labecoufsc/Power_PCB/Power PCB outline/images/diagrama-de-forças-tubo.png

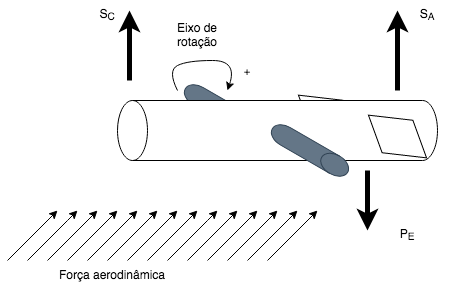
Power PCB outline/images/diagrama-de-forças-tubo.png
