labecoufsc/Power_PCB/Power PCB outline/images/diagrama-forças-final.png

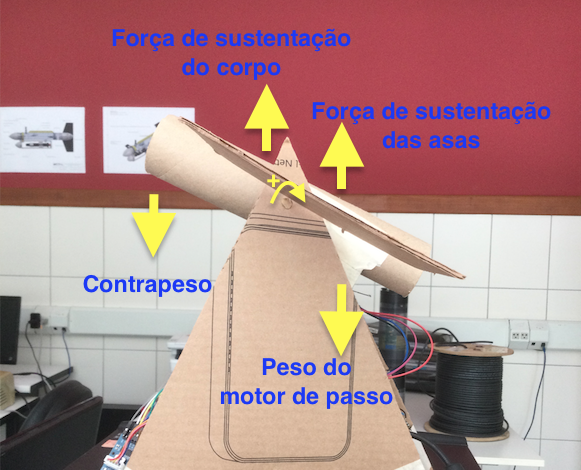
Power PCB outline/images/diagrama-forças-final.png
