labecoufsc/Power_PCB/Power PCB outline/images/espaço-motor-passo.png

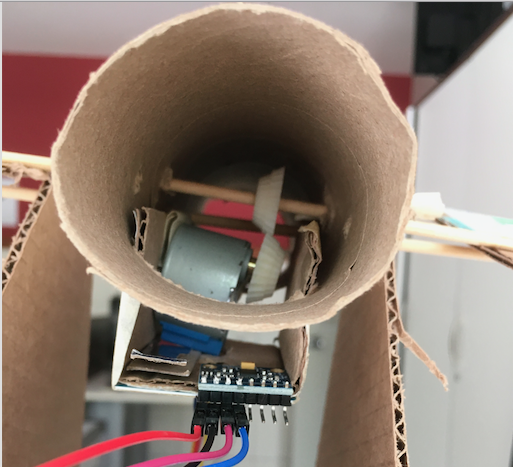
Power PCB outline/images/espaço-motor-passo.png
