labecoufsc/Power_PCB/Power PCB outline/images/inclination-angle.png

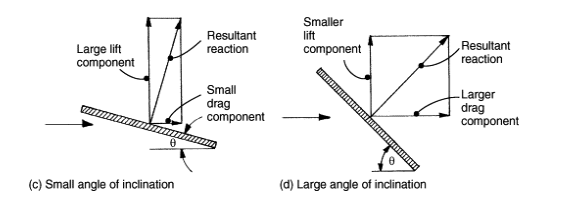
Power PCB outline/images/inclination-angle.png
