labecoufsc/Power_PCB/Power PCB outline/images/MPU6050-sensitivity.png

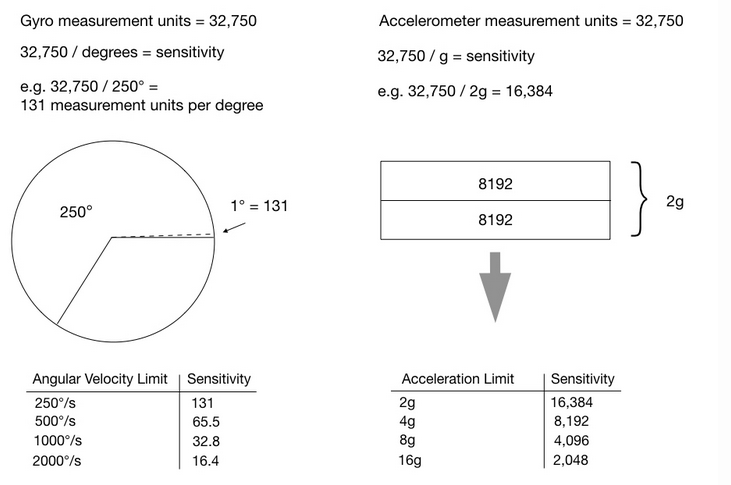
Power PCB outline/images/MPU6050-sensitivity.png
