labecoufsc/Power_PCB/Power PCB outline/images/PV-connection.png

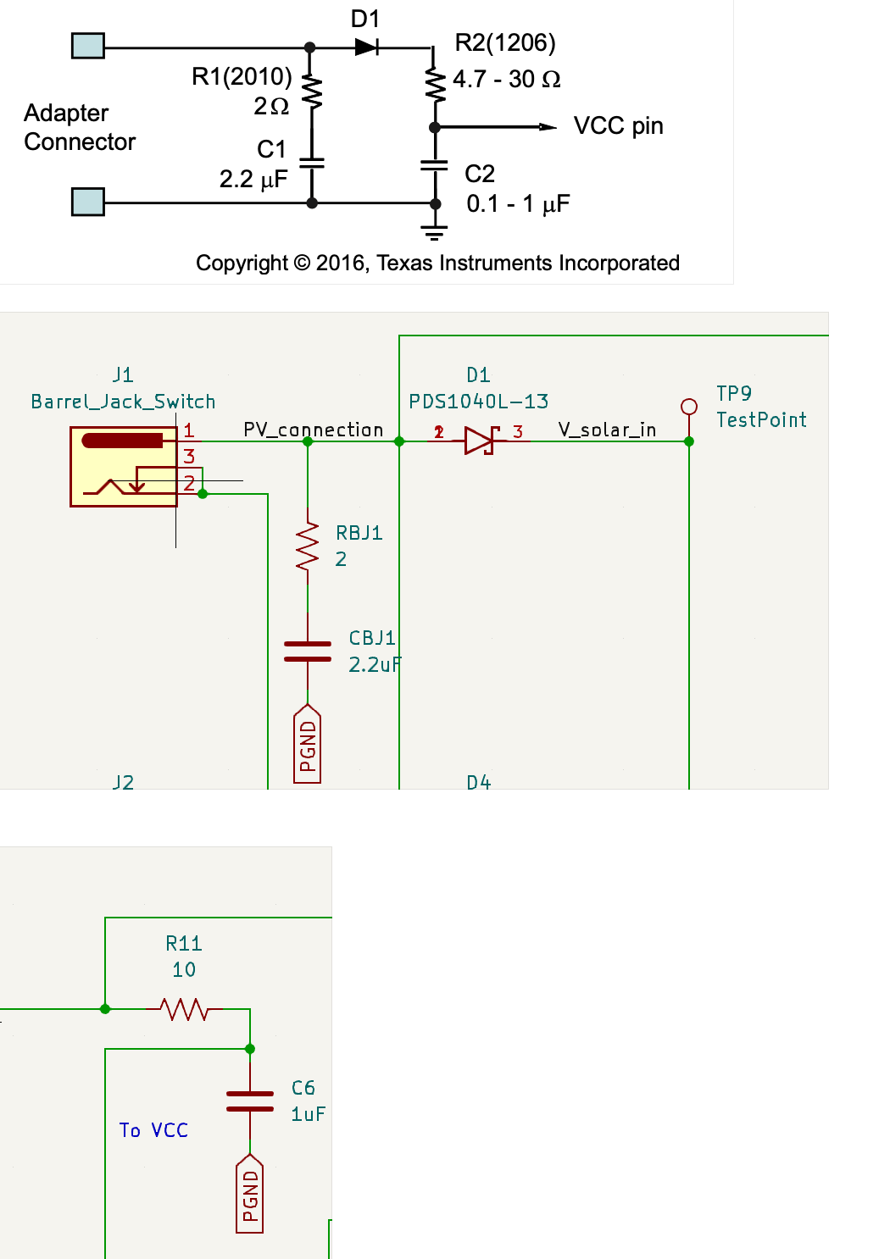
Power PCB outline/images/PV-connection.png
