labecoufsc/Power_PCB/Power PCB outline/images/torque-simulacao.png

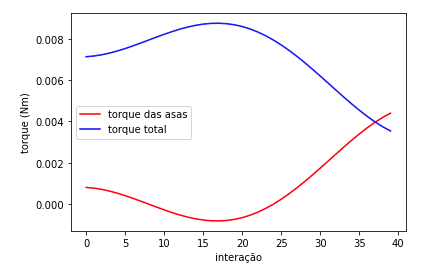
Power PCB outline/images/torque-simulacao.png
