labecoufsc/Power_PCB/Power PCB outline/images/towfish-lateral.png

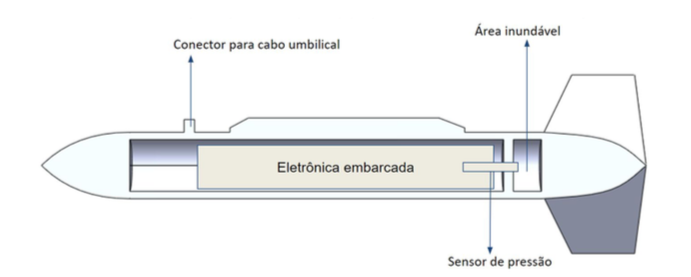
Power PCB outline/images/towfish-lateral.png
