labecoufsc/Power_PCB/Power PCB outline/images/TuboMCUInterfaces.png

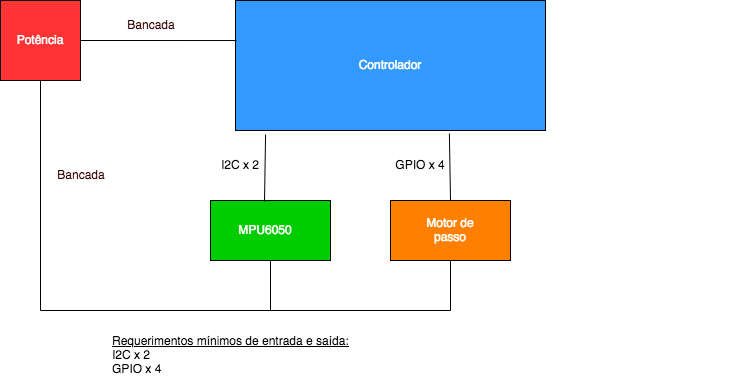
Power PCB outline/images/TuboMCUInterfaces.png
