labecoufsc/Power_PCB/Footprints/AP2112K-3.3TRG1/AP2112K-3.3TRG1.step

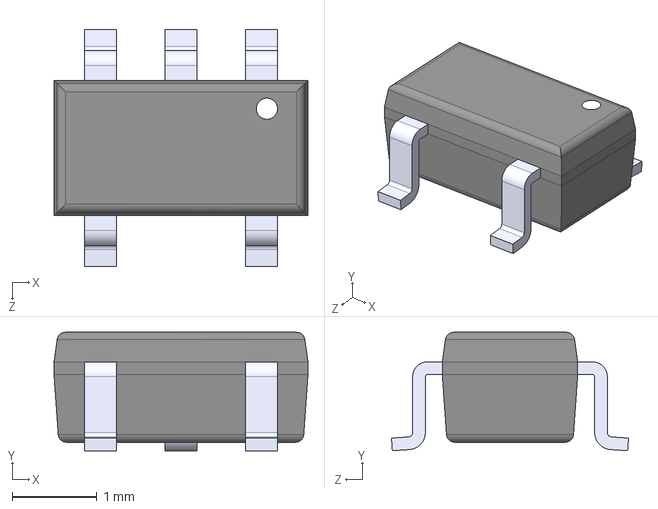
[picture p19: CAD file, 2024-03-01]
Footprints/AP2112K-3.3TRG1/AP2112K-3.3TRG1.step
3.00 x 1.40 x 2.80 mm
