labecoufsc/Power_PCB/Footprints/BS250FTA/BS250FTA.step

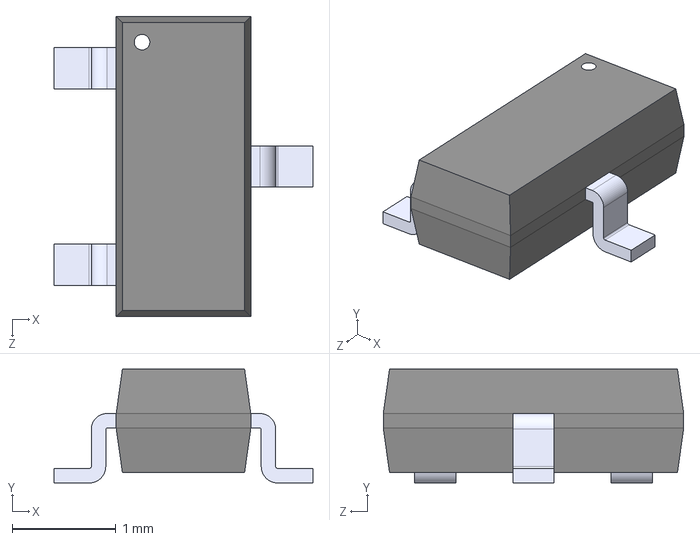
[picture p20: CAD file, 2024-04-05]
Footprints/BS250FTA/BS250FTA.step
2.50 x 1.10 x 2.90 mm
