labecoufsc/Power_PCB/Footprints/DC-005-5A-2.0/DC-005-5A-2.0.step

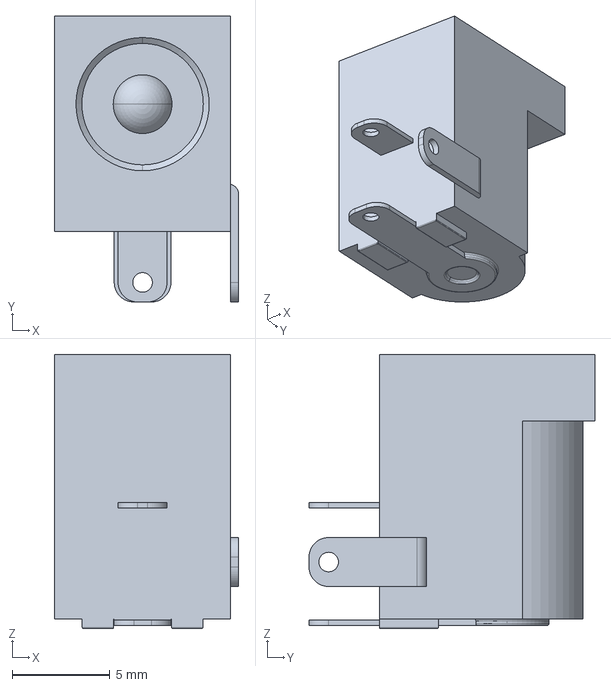
[picture p21: CAD file, 2024-04-05]
Footprints/DC-005-5A-2.0/DC-005-5A-2.0.step
9.40 x 14.6 x 14.0 mm
