labecoufsc/Power_PCB/Footprints/IRFZ44NPBF/IRFZ44NPBF.step

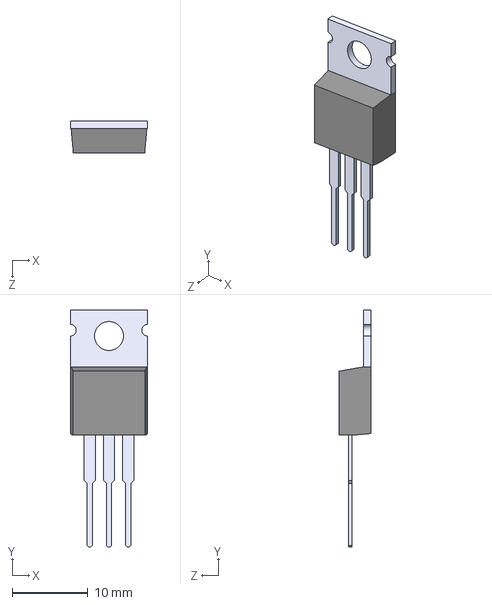
[picture p22: CAD file, 2024-04-05]
Footprints/IRFZ44NPBF/IRFZ44NPBF.step
10.2 x 31.2 x 4.19 mm
