labecoufsc/Power_PCB/Footprints/LM324DT/LM324DT.step

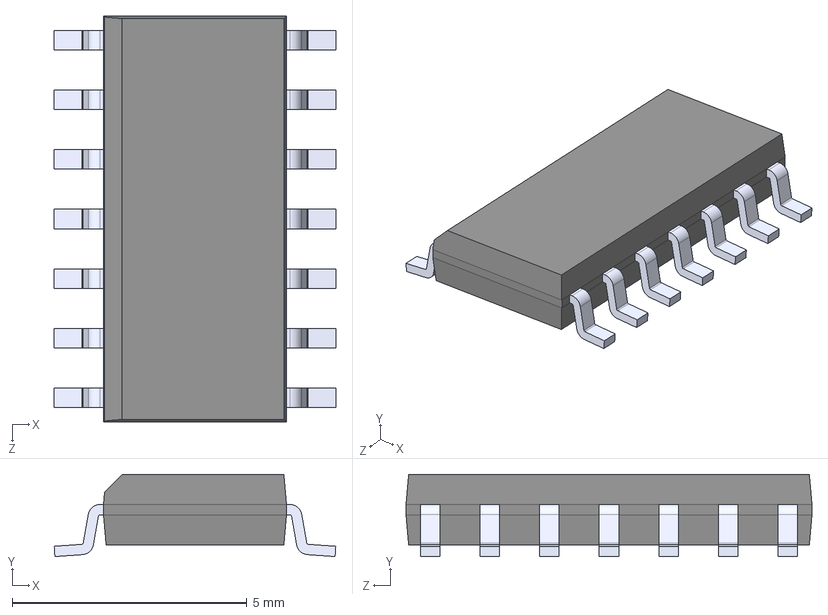
[picture p23: CAD file, 2024-03-01]
Footprints/LM324DT/LM324DT.step
6.00 x 1.75 x 8.65 mm
