labecoufsc/Power_PCB/Footprints/LTST-C190GKT/LTST-C190GKT.step

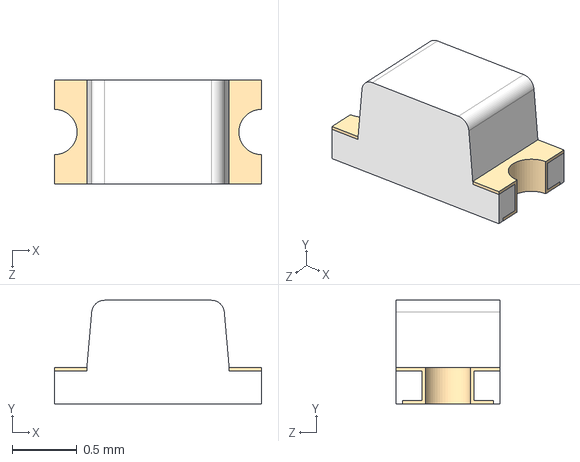
[picture p24: CAD file, 2024-03-01]
Footprints/LTST-C190GKT/LTST-C190GKT.step
1.60 x 0.8 x 0.8 mm
