labecoufsc/Power_PCB/Footprints/MINI-SPDT-SW/MINI-SPDT-SW.step

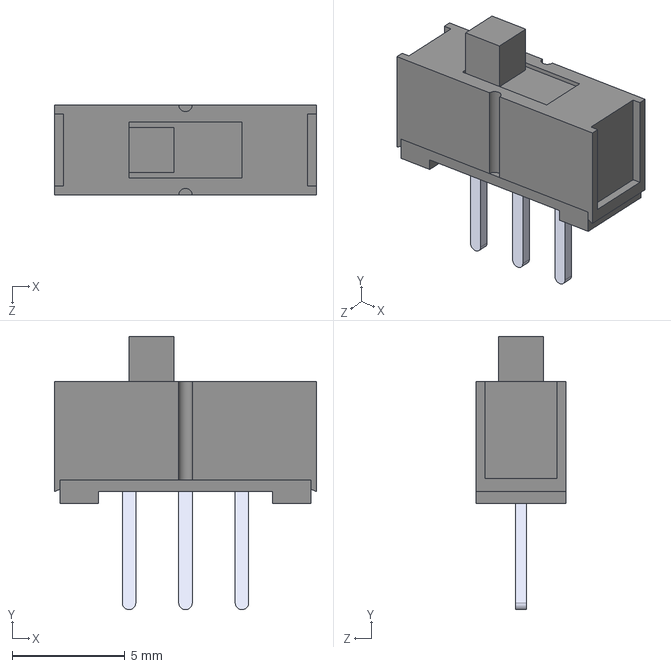
[picture p25: CAD file, 2024-04-05]
Footprints/MINI-SPDT-SW/MINI-SPDT-SW.step
11.6 x 12.1 x 4.00 mm
