labecoufsc/Power_PCB/Footprints/NTCG103JF103FT1S/NTCG103JF103FT1S.step

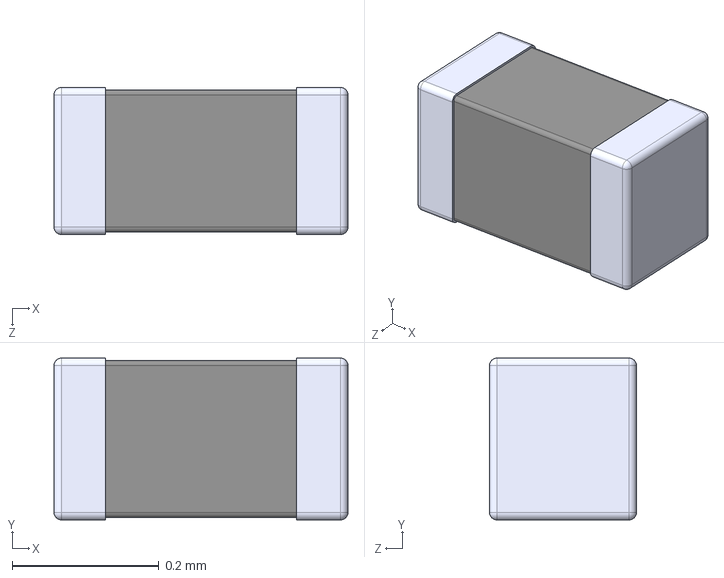
[picture p26: CAD file, 2024-04-05]
Footprints/NTCG103JF103FT1S/NTCG103JF103FT1S.step
0.4 x 0.22 x 0.2 mm
