labecoufsc/Power_PCB/Footprints/PDS1040L-13/PDS1040L-13.step

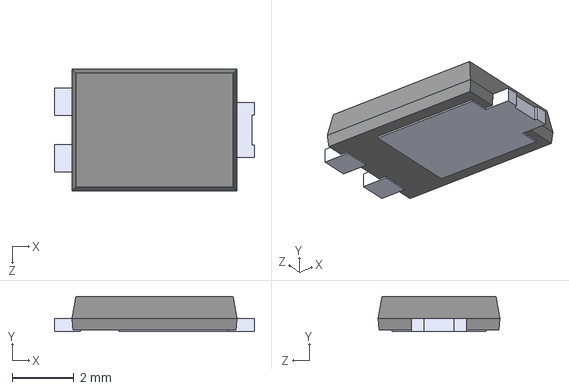
[picture p27: CAD file, 2024-03-01]
Footprints/PDS1040L-13/PDS1040L-13.step
6.50 x 1.15 x 3.97 mm
