labecoufsc/Power_PCB/Footprints/SI7288DP-T1-GE3/SI7288DP-T1-GE3.step

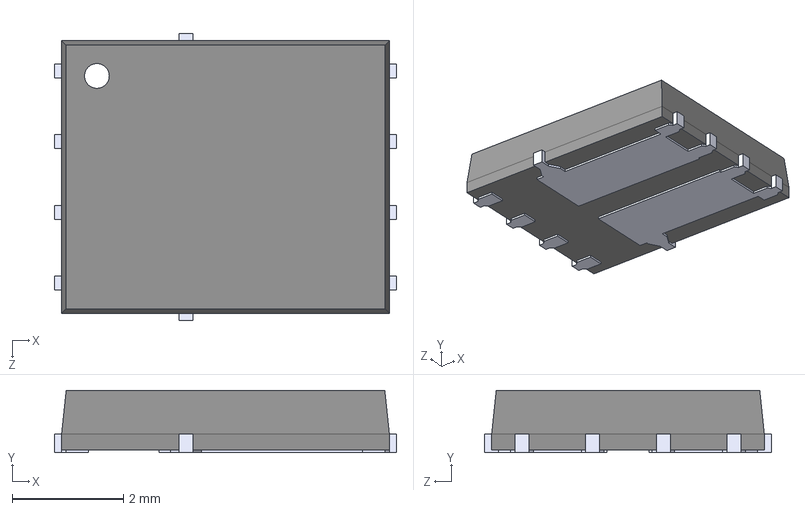
[picture p28: CAD file, 2024-03-01]
Footprints/SI7288DP-T1-GE3/SI7288DP-T1-GE3.step
6.15 x 1.12 x 5.16 mm
