labecoufsc/Power_PCB/Footprints/SN74LVC1G74DCTR/SN74LVC1G74DCTR.step

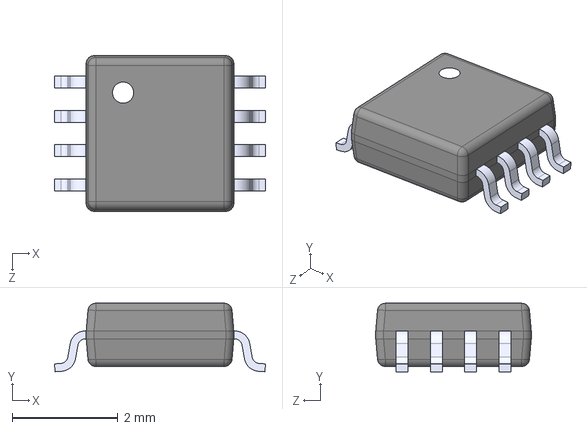
[picture p29: CAD file, 2024-03-01]
Footprints/SN74LVC1G74DCTR/SN74LVC1G74DCTR.step
4.00 x 1.30 x 2.95 mm
