labecoufsc/Power_PCB/Footprints/TPS564257DRLR/TPS564242DRLR_TEX.iges

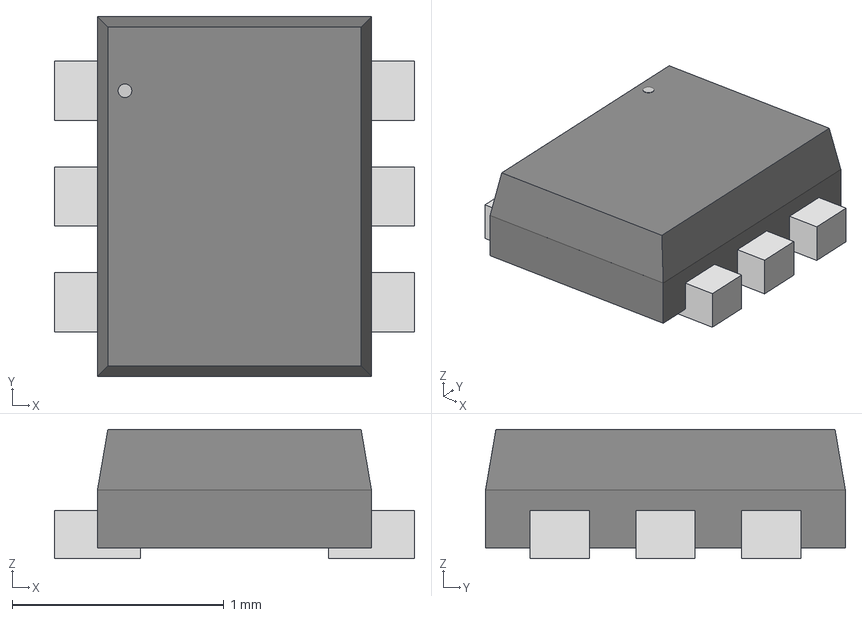
[picture p30: CAD file, 2024-04-05]
Footprints/TPS564257DRLR/TPS564242DRLR_TEX.iges
1.70 x 1.70 x 0.612 mm
