labecoufsc/Power_PCB/Footprints/BQ24650RVAR(1)/BQ24650RVAR.step

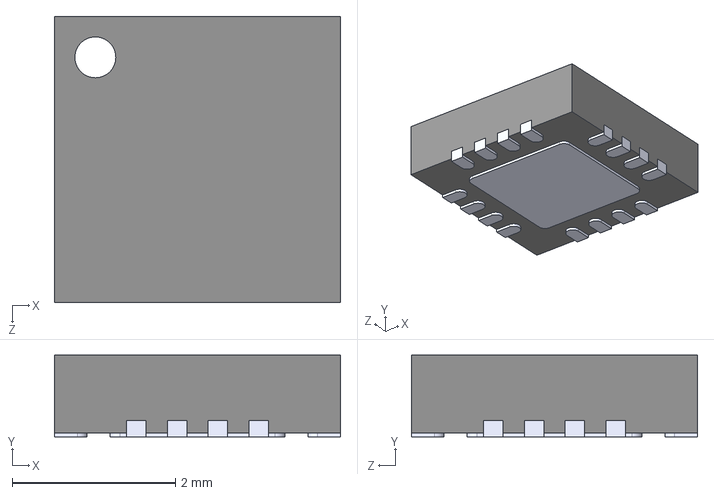
[picture p31: CAD file, 2024-03-01, an earlier design]
Footprints/BQ24650RVAR(1)/BQ24650RVAR.step
3.50 x 1.00 x 3.50 mm
