labecoufsc/Power_PCB/Buoy.kicad_pcb

## KiCad design Buoy.kicad_pcb (2024-05-13)

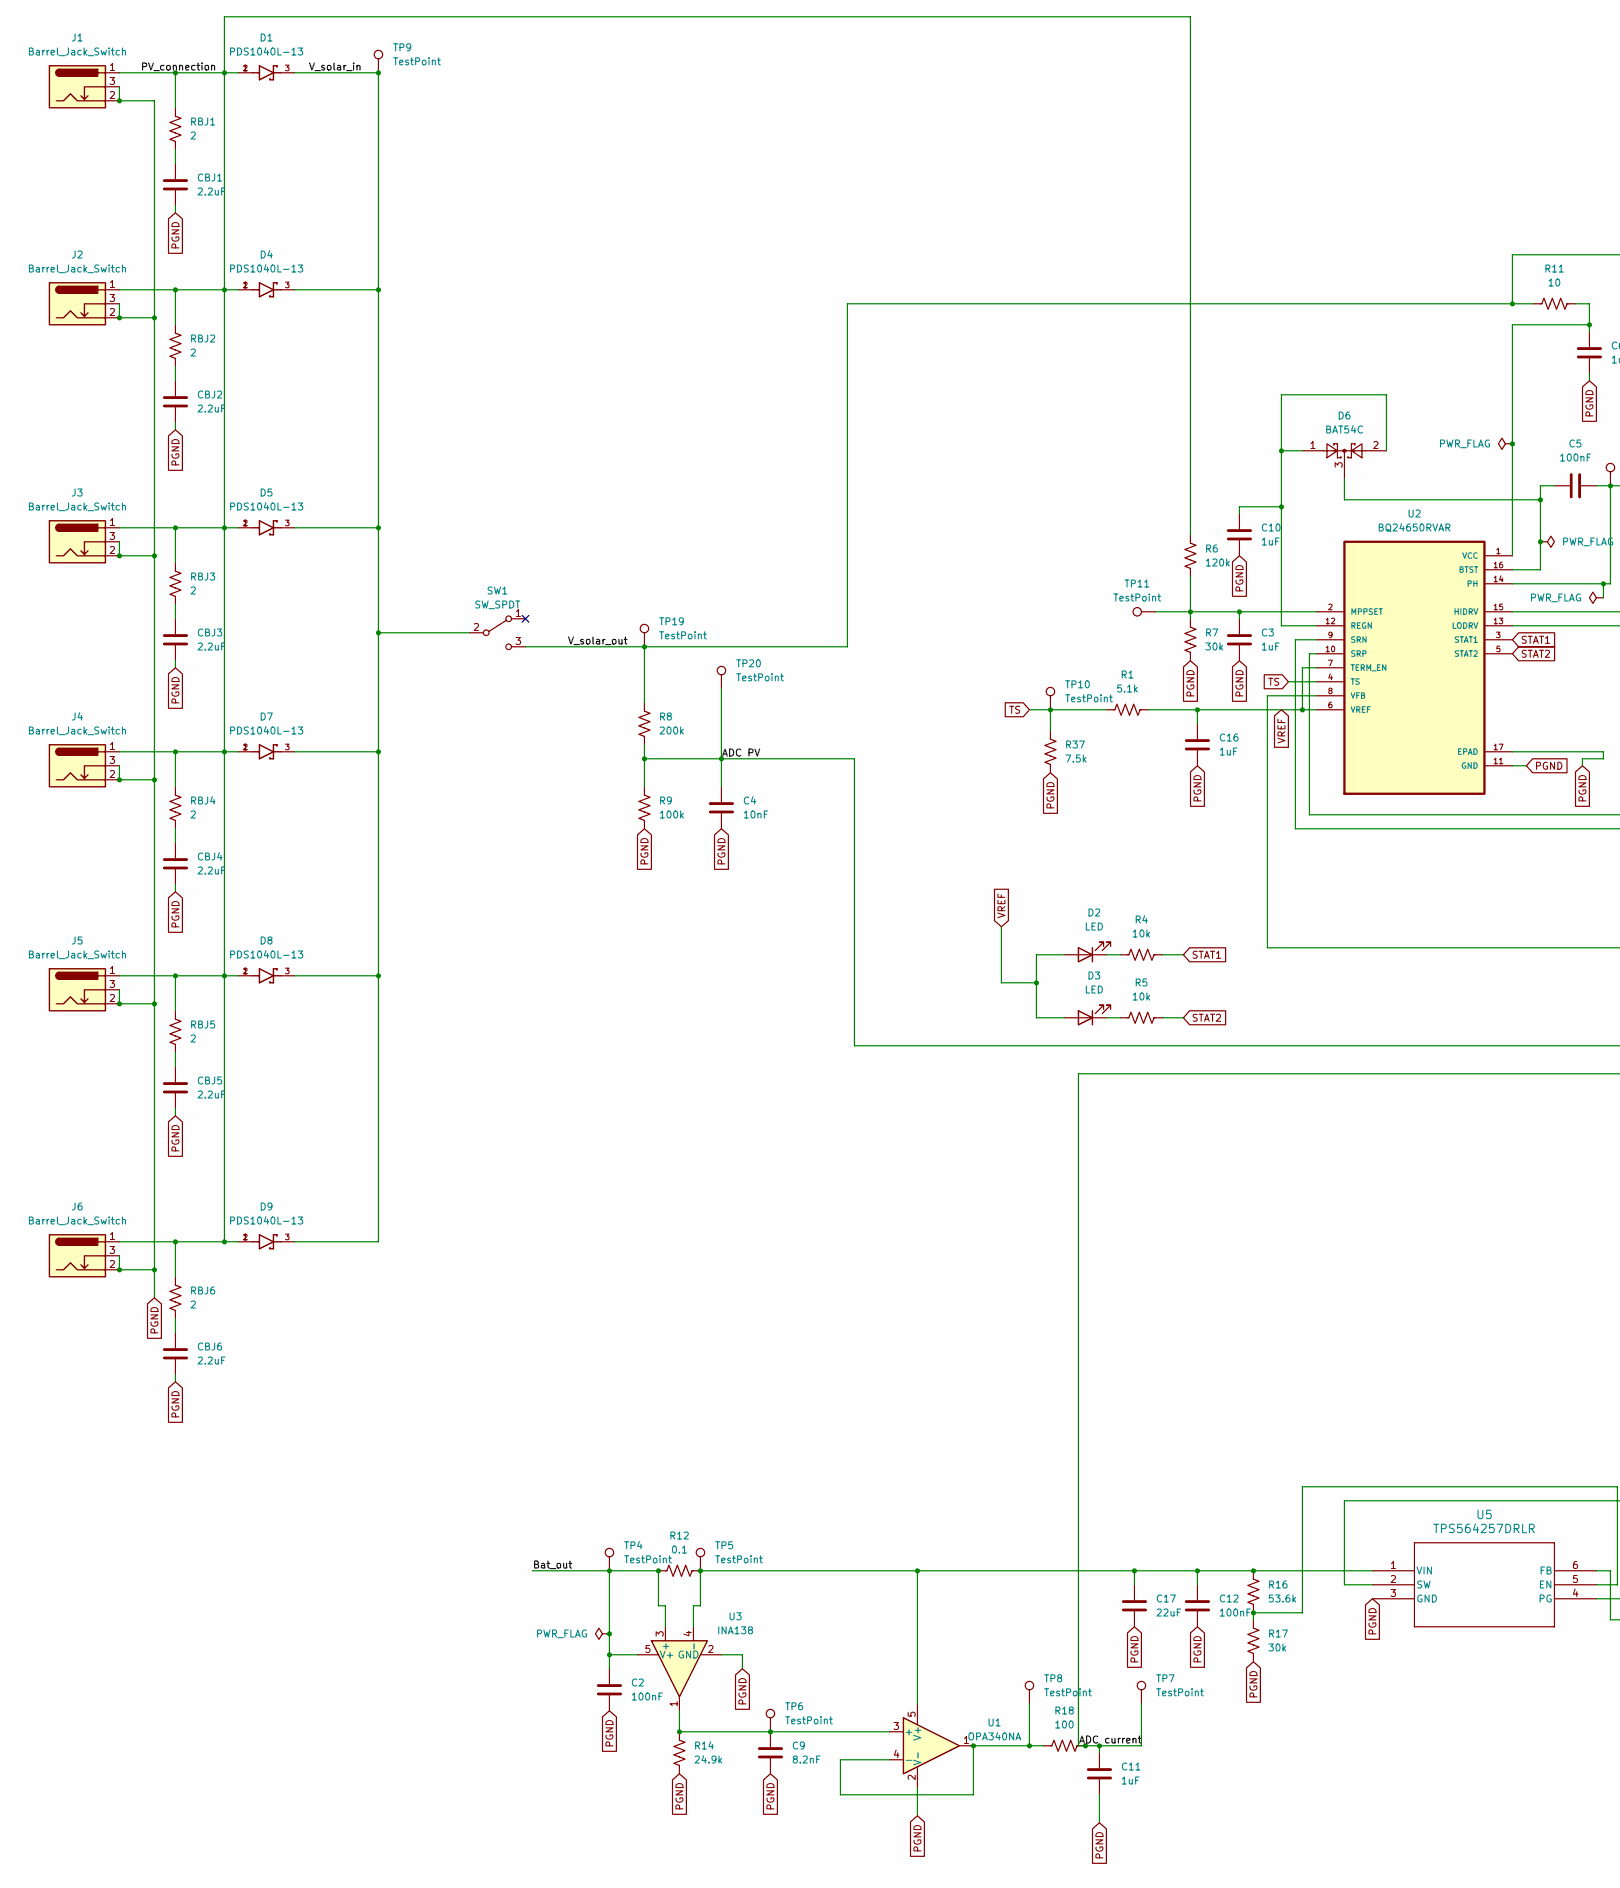
[picture p32: schematic Buoy.kicad_sch, Solar harvesting and voltage regulation, part in row 1, column 1]

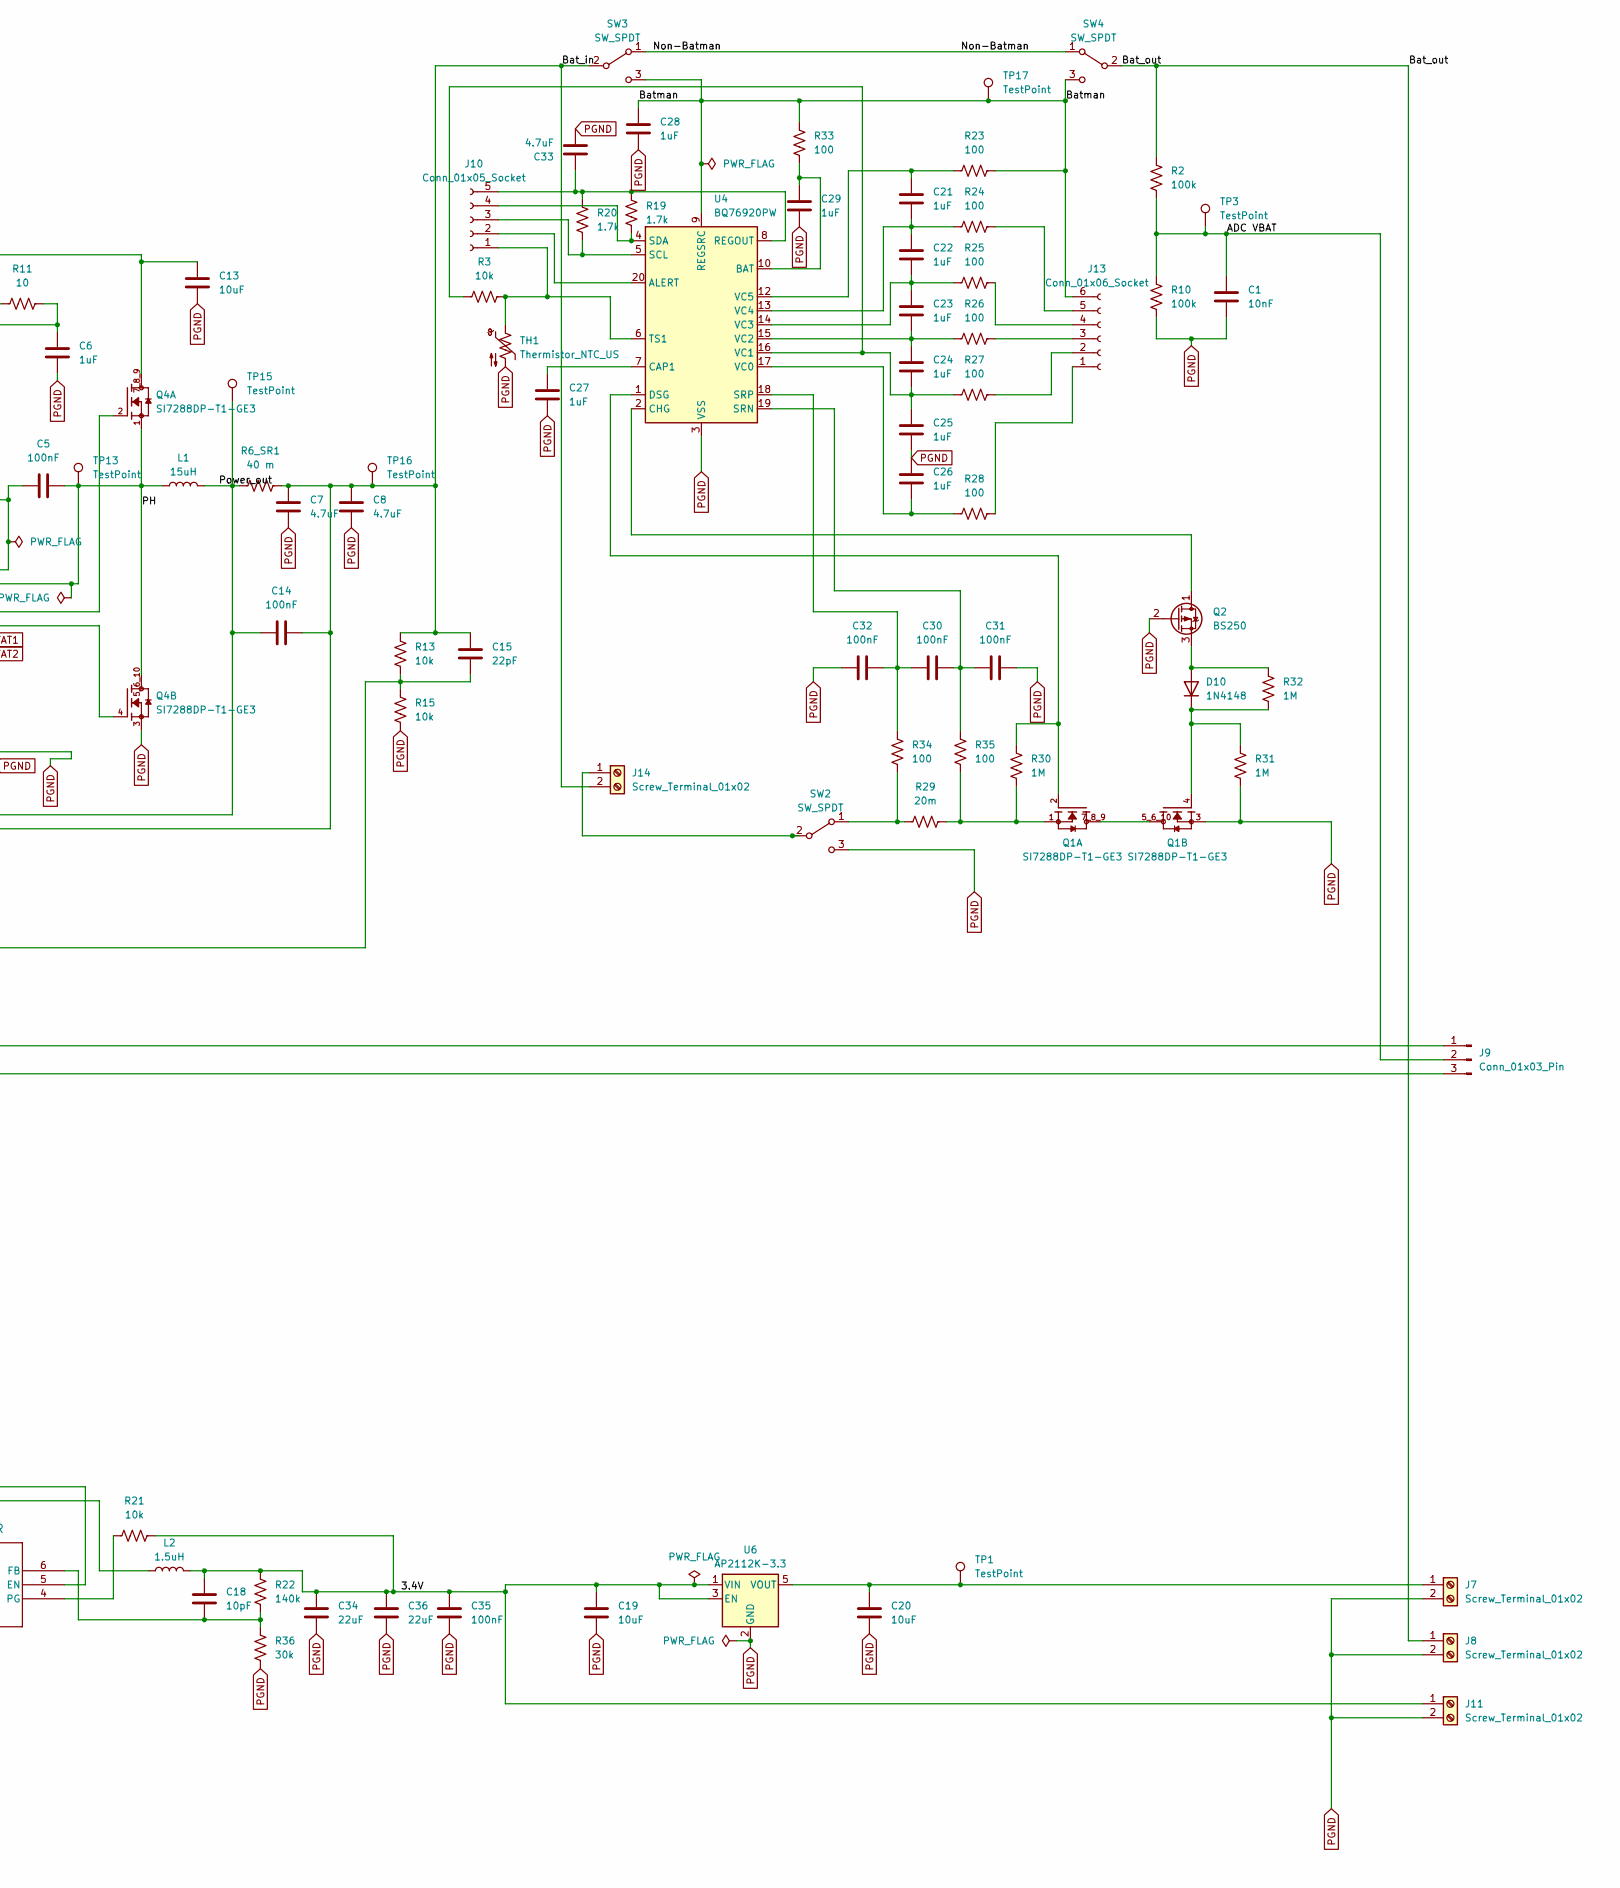
[picture p33: schematic Buoy.kicad_sch, Solar harvesting and voltage regulation, part in row 1, column 2]

Parts:
C1, C4: 10nF; C_0805_2012Metric_Pad1.18x1.45mm_HandSolder
C2, C5, C14, C30, C31, C32, C35: 100nF; C_0805_2012Metric_Pad1.18x1.45mm_HandSolder
C3, C6, C10, C16, C21, C22, C23, C24, C25, C26: 1uF; C_0805_2012Metric_Pad1.18x1.45mm_HandSolder
C7, C8: 4.7uF; C_1210_3225Metric_Pad1.33x2.70mm_HandSolder
C9: 8.2nF; C_0603_1608Metric_Pad1.08x0.95mm_HandSolder
C11, C27, C28, C29: 1uF; C_1210_3225Metric_Pad1.33x2.70mm_HandSolder
C12: 100nF; C_0603_1608Metric_Pad1.08x0.95mm_HandSolder
C13, C19, C20: 10uF; C_1206_3216Metric_Pad1.33x1.80mm_HandSolder
C15: 22pF; C_0603_1608Metric_Pad1.08x0.95mm_HandSolder
C17: 22uF; C_1210_3225Metric_Pad1.33x2.70mm_HandSolder
C18: 10pF; C_0402_1005Metric_Pad0.74x0.62mm_HandSolder
C33: 4.7uF; C_0805_2012Metric_Pad1.18x1.45mm_HandSolder
C34, C36: 22uF; C_0805_2012Metric_Pad1.18x1.45mm_HandSolder
CBJ1, CBJ2, CBJ3, CBJ4, CBJ5, CBJ6: 2.2uF; C_1210_3225Metric_Pad1.33x2.70mm_HandSolder
D1, D4, D5, D7, D8, D9: PDS1040L-13; DIO_PDS1040L-13; PARTREV 13
D2, D3: LED; LEDC1608X35N
D6: BAT54C; SOT-23_Handsoldering
D10: 1N4148; D_SOD-323_HandSoldering
J1, J2, J3, J4, J5, J6: Barrel_Jack_Switch; XKB_DC-005-5A-2.0
J7, J8, J11, J14: Screw_Terminal_01x02; CONN_1729128_PXC
J9: Conn_01x03_Pin; PinHeader_1x03_P2.54mm_Vertical_SMD_Pin1Right
J10: Conn_01x05_Socket; PinHeader_1x05_P2.54mm_Vertical_SMD_Pin1Right
J13: Conn_01x06_Socket; PinHeader_1x06_P2.54mm_Vertical_SMD_Pin1Right
L1: 15uH; L_Koher_MDA1350_13.5x12.6mm_1
L2: 1.5uH; L_Vishay_IHLP-2020
Q1, Q4: SI7288DP-T1-GE3; TRANS_SI7288DP-T1-GE3; PARTREV A
Q2: BS250; SOT95P240X110-3N
R1: 5.1k; R_1206_3216Metric_Pad1.30x1.75mm_HandSolder
R2, R9, R10: 100k; R_0402_1005Metric_Pad0.72x0.64mm_HandSolder
R3, R4, R5, R13, R15: 10k; R_0805_2012Metric_Pad1.20x1.40mm_HandSolder
R6: 120k; R_0603_1608Metric_Pad0.98x0.95mm_HandSolder
R6_SR1: 40 m; R_2010_5025Metric_Pad1.40x2.65mm_HandSolder
R7, R17, R36: 30k; R_0603_1608Metric_Pad0.98x0.95mm_HandSolder
R8: 200k; R_0603_1608Metric_Pad0.98x0.95mm_HandSolder
R11: 10; R_1206_3216Metric_Pad1.30x1.75mm_HandSolder
R12: 0.1; R_2010_5025Metric_Pad1.40x2.65mm_HandSolder
R14: 24.9k; R_0402_1005Metric_Pad0.72x0.64mm_HandSolder
R16: 53.6k; R_0402_1005Metric_Pad0.72x0.64mm_HandSolder
R18, R23, R24, R25, R26, R27, R28, R33, R34, R35: 100; R_1210_3225Metric_Pad1.30x2.65mm_HandSolder
R19, R20: 1.7k; R_1206_3216Metric_Pad1.30x1.75mm_HandSolder
R21: 10k; R_0402_1005Metric_Pad0.72x0.64mm_HandSolder
R22: 140k; R_0805_2012Metric_Pad1.20x1.40mm_HandSolder
R29: 20m; R_2010_5025Metric_Pad1.40x2.65mm_HandSolder
R30, R31, R32: 1M; R_1206_3216Metric_Pad1.30x1.75mm_HandSolder
R37: 7.5k; R_0402_1005Metric_Pad0.72x0.64mm_HandSolder
RBJ1, RBJ2, RBJ3, RBJ4, RBJ5, RBJ6: 2; R_2512_6332Metric_Pad1.40x3.35mm_HandSolder
SW1, SW2, SW3, SW4: SW_SPDT; SW-SPDT-SW
TH1: Thermistor_NTC_US; THRMC1005X55N
TP1, TP3, TP4, TP5, TP6, TP7, TP8, TP9, TP10, TP11, TP13, TP15, TP16, TP17, TP19, TP20: TestPoint; TestPoint_Pad_1.0x1.0mm
U1: OPA340NA; SOT-23-5
U2: BQ24650RVAR; QFN50P350X350X100-17N
U3: INA138; SOT95P280X145-5N
U4: BQ76920PW; TSSOP-20_4.4x6.5mm_P0.65mm
U5: TPS564257DRLR; TPS564242DRLR_TEX
U6: AP2112K-3.3; SOT95P285X140-5N

Connections:
/3.4V: C18.1, C19.1, C34.1, C35.1, C36.1, J11.1, L2.2, R21.2, R22.1, U6.1 (VIN), U6.3 (EN); also elsewhere on the board
/ADC PV: C4.1, J9.1, R8.2, R9.1, TP20.1
/ADC VBAT: C1.1, J9.2, R2.2, R10.1, TP3.1
/ADC current: C11.1, J9.3, R18.2, TP7.1
/Bat_in: C7.1, C8.1, C14.2, C15.1, J14.2, R6_SR1.2, R13.1, SW3.2 (B), TP16.1, U2.9 (SRN)
/Bat_out: C2.1, J8.1, R2.1, R12.1, SW4.2 (B), TP4.1, U3.3 (+), U3.5 (V+)
/Batman: C28.1, J13.6, R23.2, R33.1, SW3.3 (C), SW4.3 (C), TP17.1, U4.9 (REGSRC)
/Non-Batman: SW3.1 (A), SW4.1 (A)
/PH: C5.2, L1.1, Q4.1, Q4.5_6_10, TP13.1, U2.14 (PH)
/PV_connection: D1.1, D1.2, D4.1, D4.2, D5.1, D5.2, D7.1, D7.2, D8.1, D8.2, D9.1, D9.2, J1.1, J2.1, J3.1, J4.1, J5.1, J6.1, R6.1, RBJ1.1, RBJ2.1, RBJ3.1, RBJ4.1, RBJ5.1, RBJ6.1
/Power_out: C14.1, L1.2, R6_SR1.1, TP15.1, U2.10 (SRP)
/V_solar_in: D1.3, D4.3, D5.3, D7.3, D8.3, D9.3, SW1.2 (B), TP9.1
/V_solar_out: C13.1, Q4.7_8_9, R8.1, R11.1, SW1.3 (C), TP19.1; also elsewhere on the board
unnamed: CBJ1.1, RBJ1.2
unnamed: CBJ2.1, RBJ2.2
unnamed: CBJ3.1, RBJ3.2
unnamed: CBJ4.1, RBJ4.2
unnamed: CBJ5.1, RBJ5.2
unnamed: CBJ6.1, RBJ6.2
unnamed: D2.1 (K), R4.1
unnamed: D3.1 (K), R5.1
unnamed: D10.2 (A), Q2.3 (S), R32.1
unnamed: D10.1 (K), Q1.4, R31.1, R32.2
unnamed: C20.1, J7.1, TP1.1, U6.5 (VOUT)
unnamed: J10.1, R3.2, TH1.1, U4.6 (TS1)
unnamed: J10.2, U4.20 (ALERT)
unnamed: J10.3, R20.2, U4.5 (SCL)
unnamed: J10.4, R19.2, U4.4 (SDA)
unnamed: C33.1, J10.5, R19.1, R20.1, U4.8 (REGOUT)
unnamed: J13.1, R28.2
unnamed: J13.2, R27.2
unnamed: J13.3, R26.2
unnamed: J13.4, R25.2
unnamed: J13.5, R24.2
unnamed: J14.1, SW2.2 (B)
unnamed: Q1.1, R29.2, R30.2, R35.2
unnamed: Q1.5_6_10, Q1.7_8_9
unnamed: Q2.1 (D), U4.2 (CHG)
unnamed: R29.1, R34.2, SW2.1 (A)
unnamed: C9.1, R14.1, TP6.1, U1.3 (+), U3.1
unnamed: R18.1, TP8.1, U1.1, U1.4 (-)
unnamed: C12.1, C17.1, R12.2, R16.1, TP5.1, U1.5 (V+), U3.4 (-), U5.1 (VIN)
unnamed: C5.1, D6.3, U2.16 (BTST)
unnamed: Q4.2, U2.15 (HIDRV)
unnamed: Q4.4, U2.13 (LODRV)
unnamed: C3.1, R6.2, R7.1, TP11.1, U2.2 (MPPSET)
unnamed: C10.1, D6.1, D6.2, U2.12 (REGN)
unnamed: C6.1, R11.2, U2.1 (VCC)
unnamed: C15.2, R13.2, R15.1, U2.8 (VFB)
unnamed: C29.1, R33.2, U4.10 (BAT)
unnamed: C27.1, U4.7 (CAP1)
unnamed: Q1.2, R30.1, U4.1 (DSG)
unnamed: C30.1, C31.1, R35.1, U4.19 (SRN)
unnamed: C30.2, C32.2, R34.1, U4.18 (SRP)
unnamed: C26.2, R28.1, U4.17 (VC0)
unnamed: C24.2, C25.1, R3.1, R27.1, U4.16 (VC1)
unnamed: C23.2, C24.1, R26.1, U4.15 (VC2)
unnamed: C22.2, C23.1, R25.1, U4.14 (VC3)
unnamed: C21.2, C22.1, R24.1, U4.13 (VC4)
unnamed: C21.1, R23.1, U4.12 (VC5)
unnamed: R16.2, R17.1, U5.5 (EN)
unnamed: C18.2, R22.2, R36.1, U5.6 (FB)
unnamed: R21.1, U5.4 (PG)
unnamed: L2.1, U5.2 (SW)
PGND: C1.2, C2.2, C3.2, C4.2, C6.2, C7.2, C8.2, C9.2, C10.2, C11.2, C12.2, C13.2, C16.2, C17.2, C19.2, C20.2, C25.2, C26.1, C27.2, C28.2, C29.2, C31.2, C32.1, C33.2, C34.2, C35.2, C36.2, CBJ1.2, CBJ2.2, CBJ3.2, CBJ4.2, CBJ5.2, CBJ6.2, J1.2, J1.3, J2.2, J2.3, J3.2, J3.3, J4.2, J4.3, J5.2, J5.3, J6.2, J6.3, J7.2, J8.2, J11.2, Q1.3, Q2.2 (G), Q4.3, R7.2, R9.2, R10.2, R14.2, R15.2, R17.2, R31.2, R36.2, R37.2, SW2.3 (C), TH1.2, U1.2 (V-), U2.11 (GND), U2.17 (EPAD), U3.2 (GND), U4.3 (VSS), U5.3 (GND), U6.2 (GND)
STAT1: R4.2, U2.3 (STAT1)
STAT2: R5.2, U2.5 (STAT2)
TS: R1.1, R37.1, TP10.1, U2.4 (TS)
VREF: C16.1, D2.2 (A), D3.2 (A), R1.2, U2.6 (VREF), U2.7 (TERM_EN)

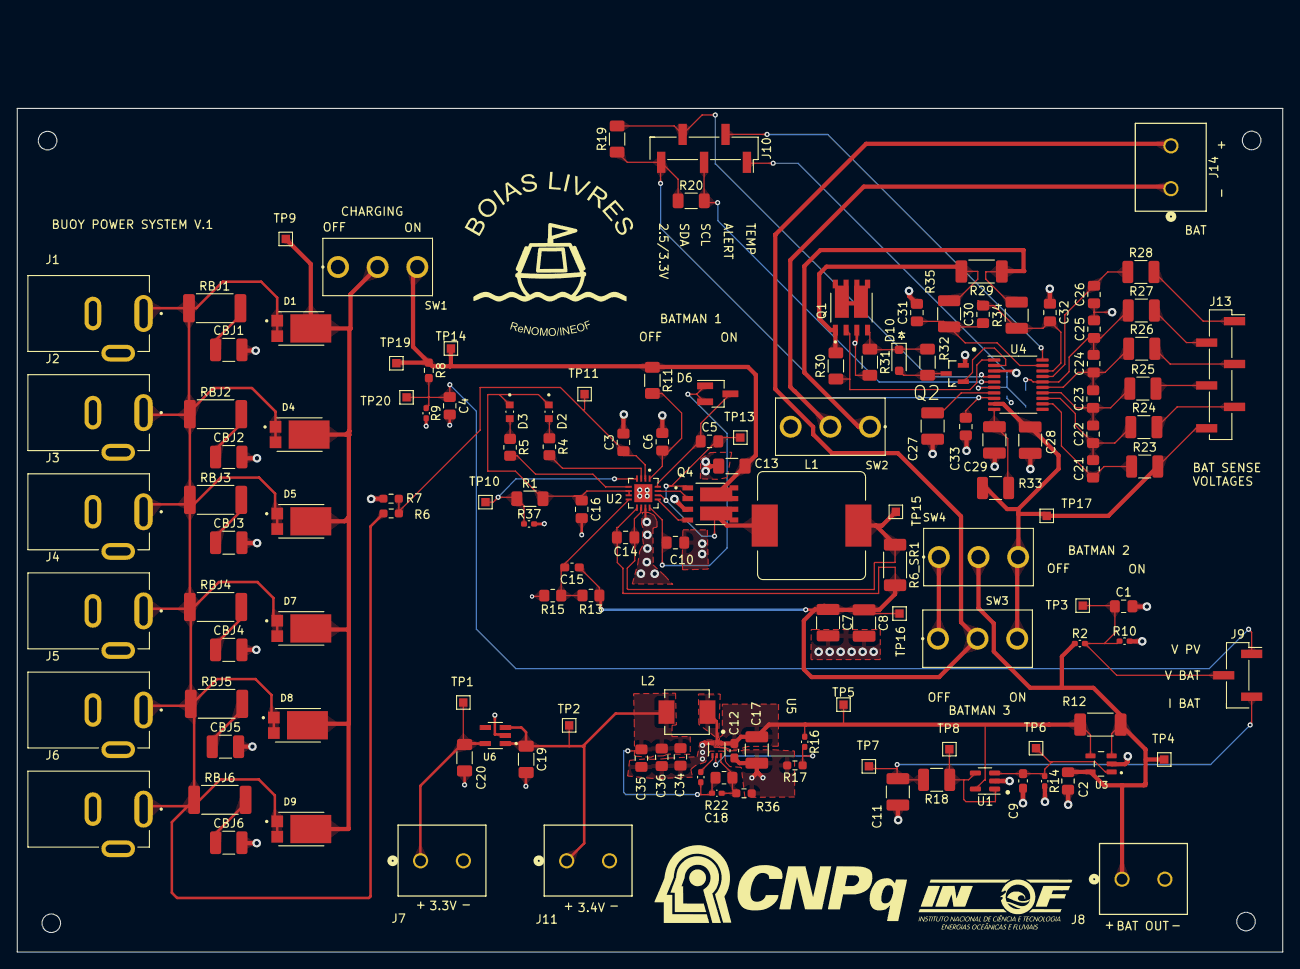
[picture p34: board Buoy.kicad_pcb from above]

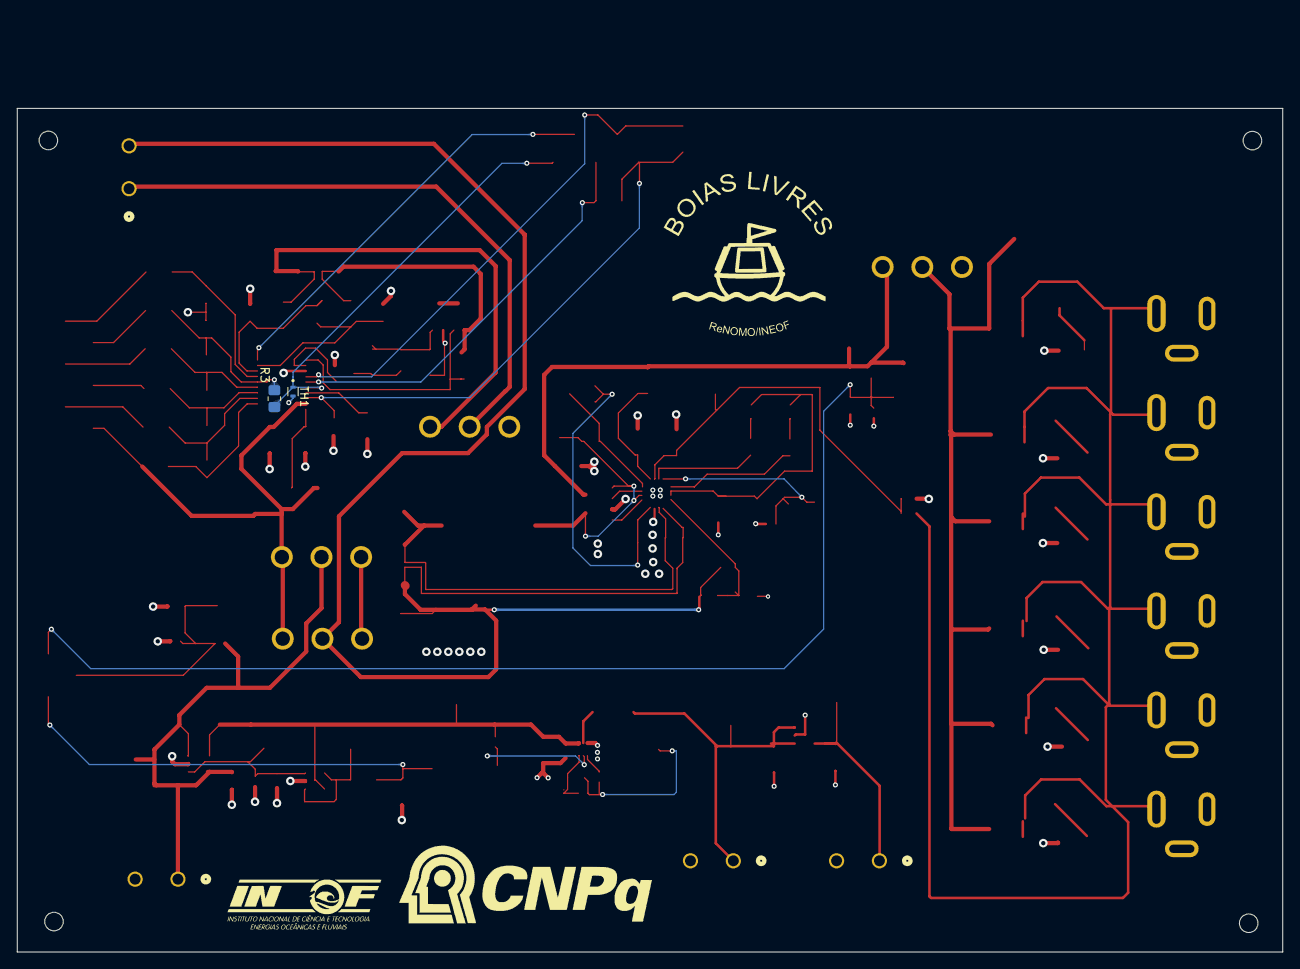
[picture p35: board Buoy.kicad_pcb from below]

Board: 4 copper layers, 150.0 x 100.0 mm, 145 parts (3 on the bottom side), 69 nets.

Other parts of the board:
., .#2: LOGO; CNPQ
TP2, TP14: TestPoint; TestPoint_Pad_1.0x1.0mm

Their connections:
/3.4V: TP2.1; also elsewhere on the board
/V_solar_out: TP14.1; also elsewhere on the board
