labecoufsc/Power_PCB/(commit log)

2024-03-01 INA138 current control
    [AP2112K-3.3TRG1.step, BQ24650RVAR.step, Buoy.csv, Buoy_update.csv, INA138NA_3K.step, LM324DT.step, LTST-C190GKT.step, PDS1040L-13.step]
2024-04-05 version 1 for consultation
    [BQ24650RVAR.step, BS250FTA.step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]
2024-05-13 submitted for production
    [Buoy-B_Cu.gbr, Buoy-B_Mask.gbr, Buoy-B_Paste.gbr, Buoy-B_Silkscreen.gbr, Buoy-Edge_Cuts.gbr, Buoy-F_Cu.gbr, Buoy-F_Mask.gbr, Buoy-F_Paste.gbr]
